acolab/line_follower_robot/README.md

# line_follower_robot
FR :
Ce repository permet de construire et programmer un robot à deux roues capable de suivre une ligne noire.
Il comprend:
- BOM.md : la liste du matériel
- base/line_follower_base.dxf : fichier décrivant la base du robot
- base/line_follower_base.scad : fichier openScad permettant de modifier la base du robot

EN :
