acolab/line_follower_robot/Robots suiveurs de lignes.pdf

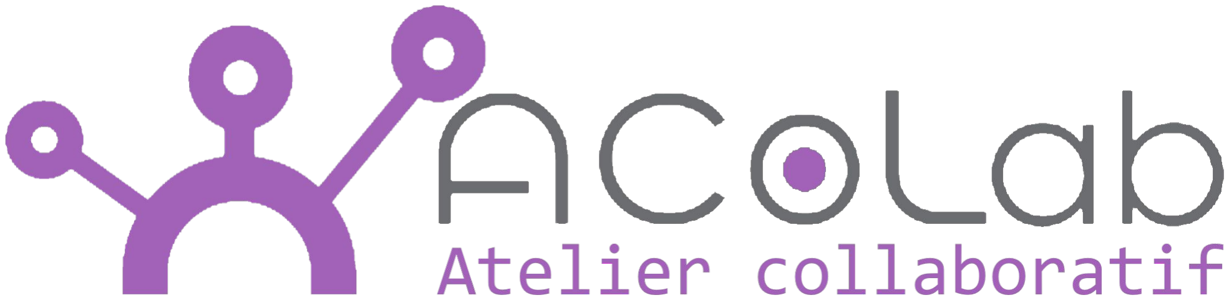
[picture p1: figure]

# atelier robots suiveurs de lignes

## Programme

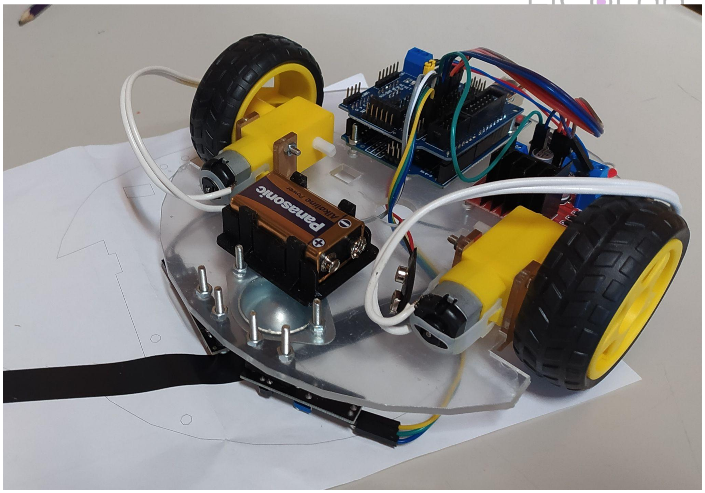
[picture p2: figure]

- Visite de l‘ACoLab
- Montage mécanique
- Détection des lignes
- Suivi des lignes

## ACoLab : atelier collaboratif

- Un lieu pour réaliser vos projets
- Un atelier avec des machines à dispositions des adhérents
- Des formations à l’usage des machines et des technologies
- Fonctionnement uniquement bénévole

## CONNEXIONS, cultivons le numérique

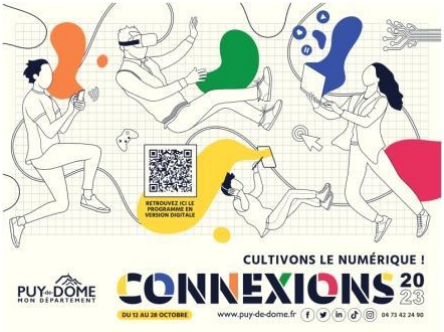
[picture p3: figure]

## Description du robot

Robot ‘differential drive’ : deux roues centrales indépendantes + 1 roulette

- base plexiglas, vis, écrous, roue libre
- 2 moteur + supports + roue
- 2 capteurs infrarouge + support
- carte L298N pour l’alimentation de l’arduino et le pilotage des moteurs
- carte arduino pour la programmation
- carte sensor shield v5
- pile 9V + support + connecteur
- interrupteur, câbles dupont

## Soudure

Couper et dénuder 5 à 10 cm de câble
Souder le câble rouge du connecteur de pile sur le I de l’interrupteur
Souder le petit câble sur le O de l’interrupteur
Mettre une cosse sur le petit câble et une sur le câble noir du connecteur de pile

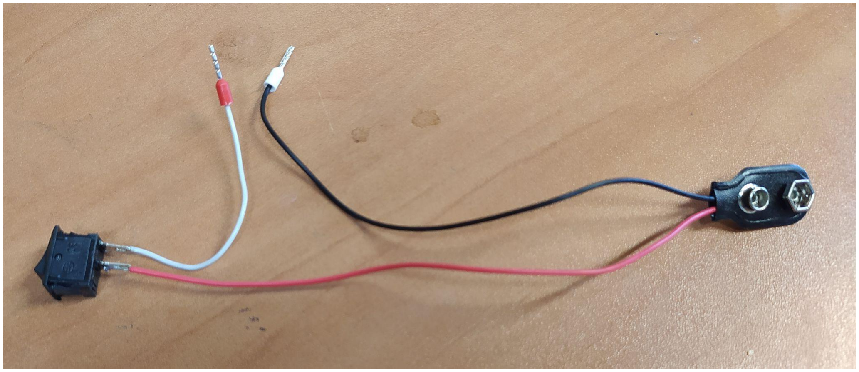
[picture p4: figure]

## Montage mécanique

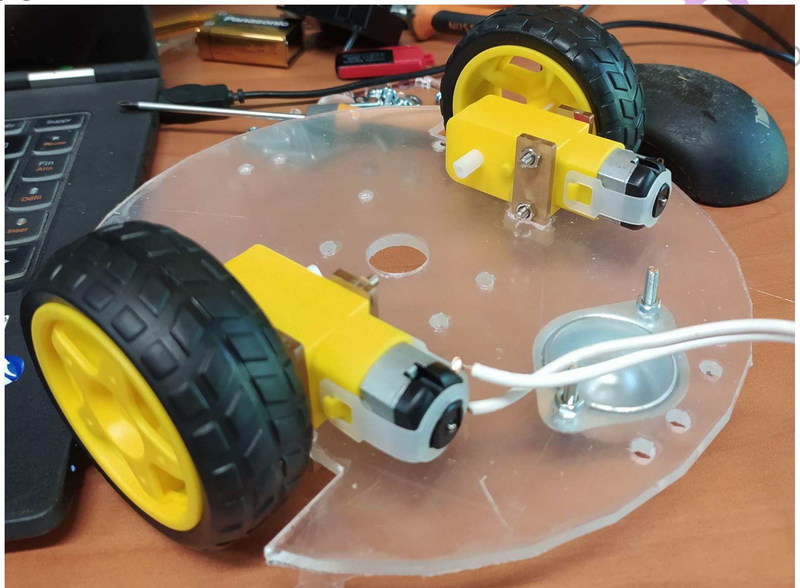
[picture p5: figure]

moteurs et roues

roue libre

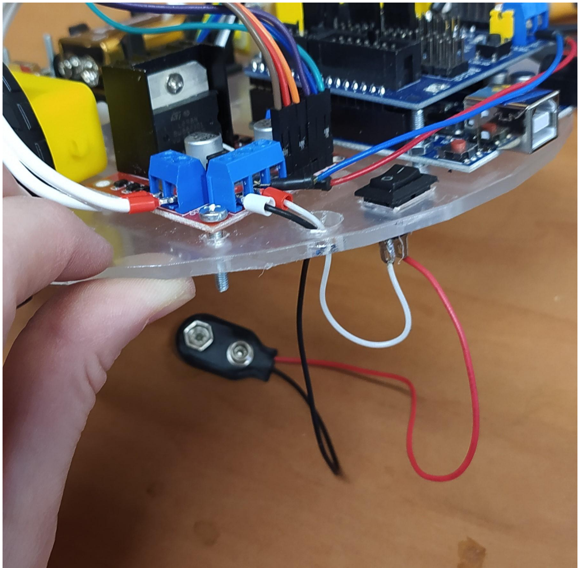
[picture p6: figure]

## Montage mécanique

support de pile + interrupteur

## Montage mécanique

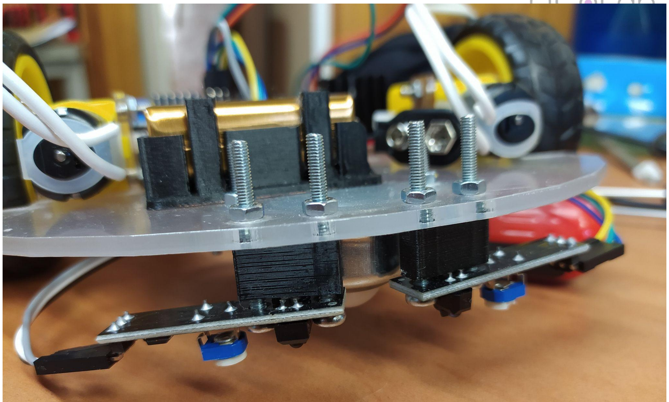
[picture p7: figure]

capteurs infrarouge

## Carte arduino

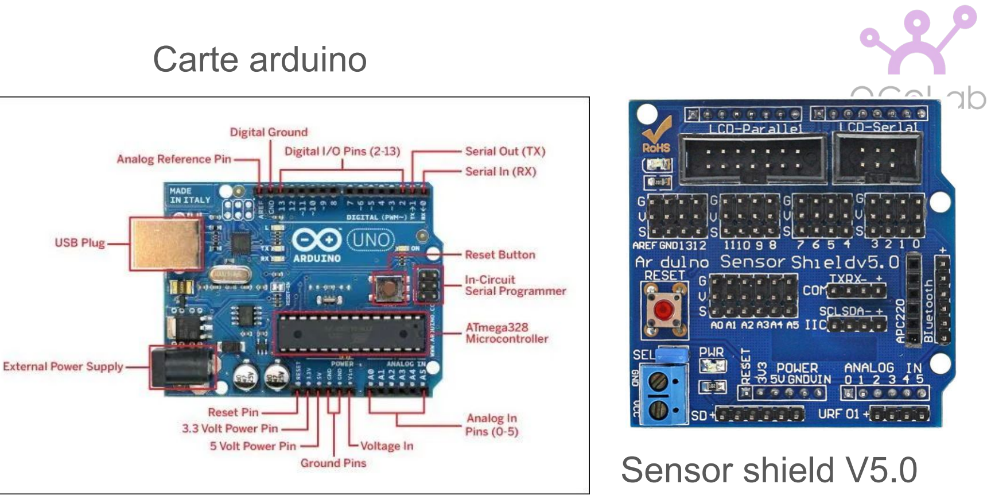
[picture p8: page 10]

## Sensor shield V5.0

## Montage mécanique

carte arduino, carte sensor shield V5

câblage capteur infrarouge sur le 2 et le 3

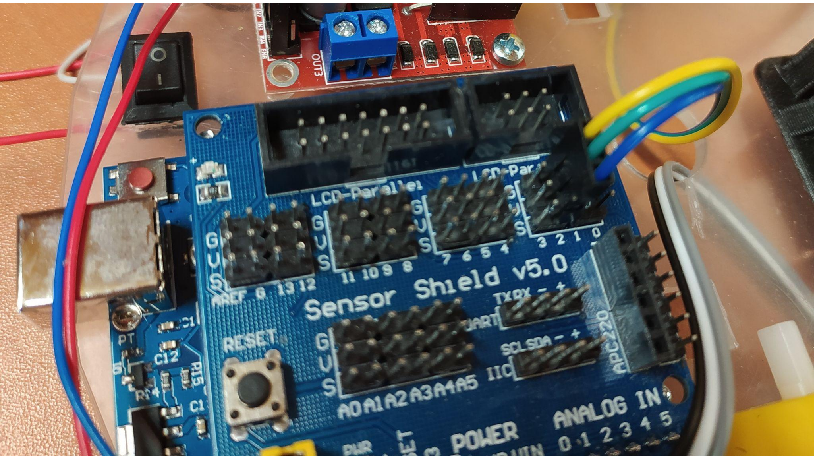
[picture p9: figure]

## Carte arduino

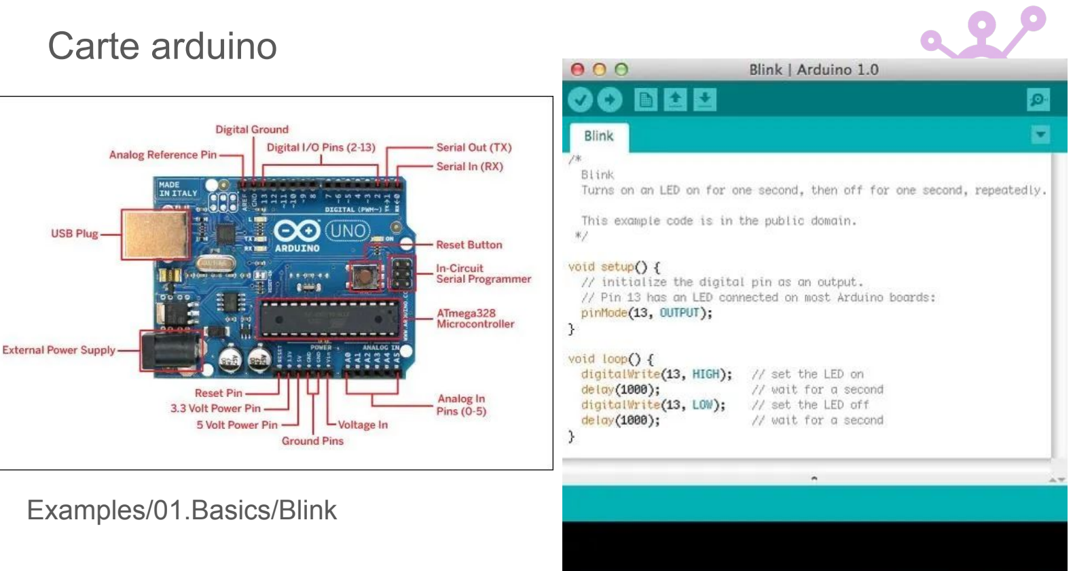
[picture p10: page 12]

Examples/01.Basics/Blink

## Capteurs infrarouge

- alimenter l’arduino avec le cable USB
- Voir que le capteur infrarouge s’allume/s’éteint en fonction de la présence du noir/blanc
- régler les potentiomètres sur le capteurs pour la détection de la ligne

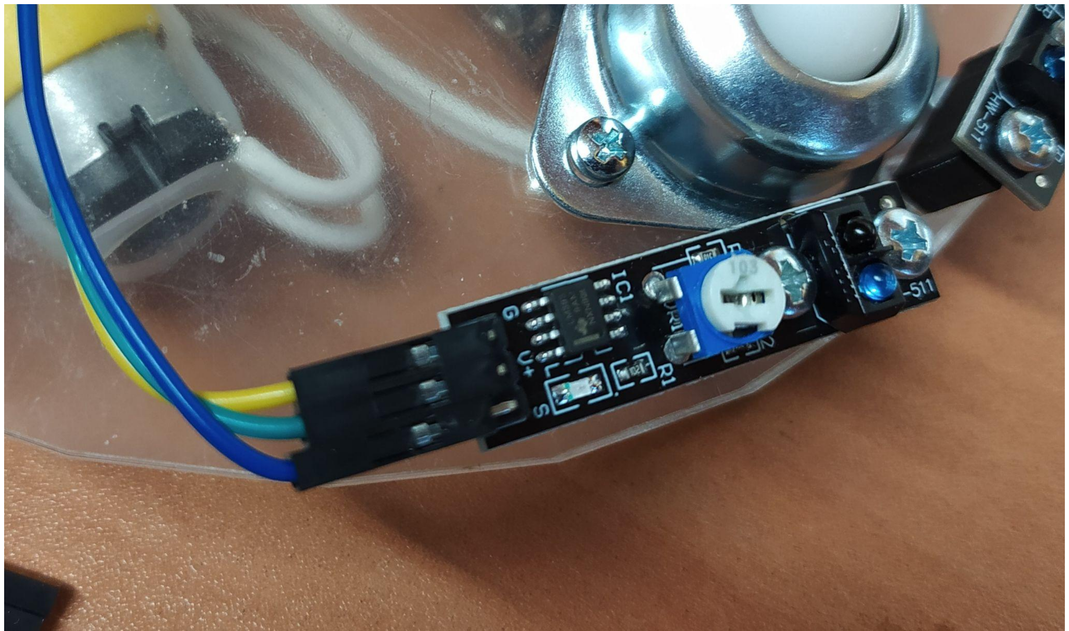
[picture p11: figure]

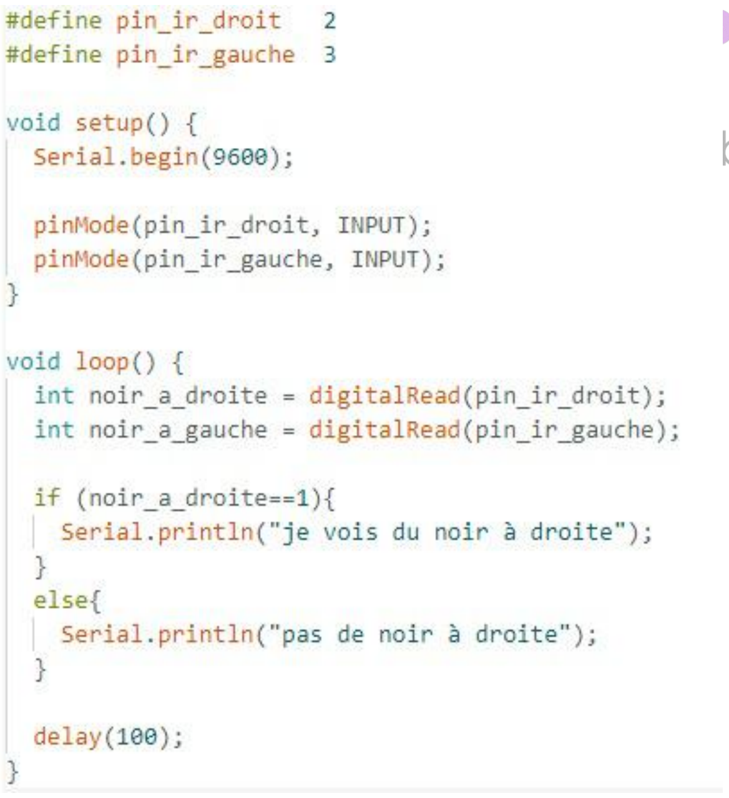
[picture p12: figure]

## Capteurs infrarouge

- code arduino
- Examples/01.Basics/

DigitalReadSerial

## Carte L298N

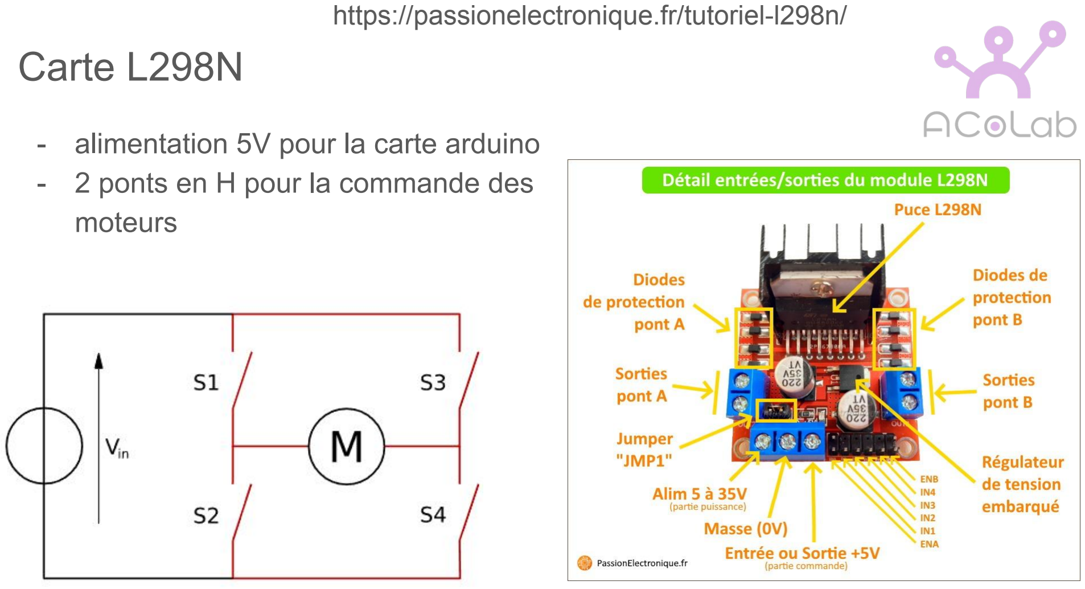
[picture p13: page 15]

- alimentation 5V pour la carte arduino
- 2 ponts en H pour la commande des moteurs

https://passionelectronique.fr/tutoriel-l298n/

## Carte L298N

- moteur gauche vers out2
- moteur droit vers out3
- interrupteur vers +12V

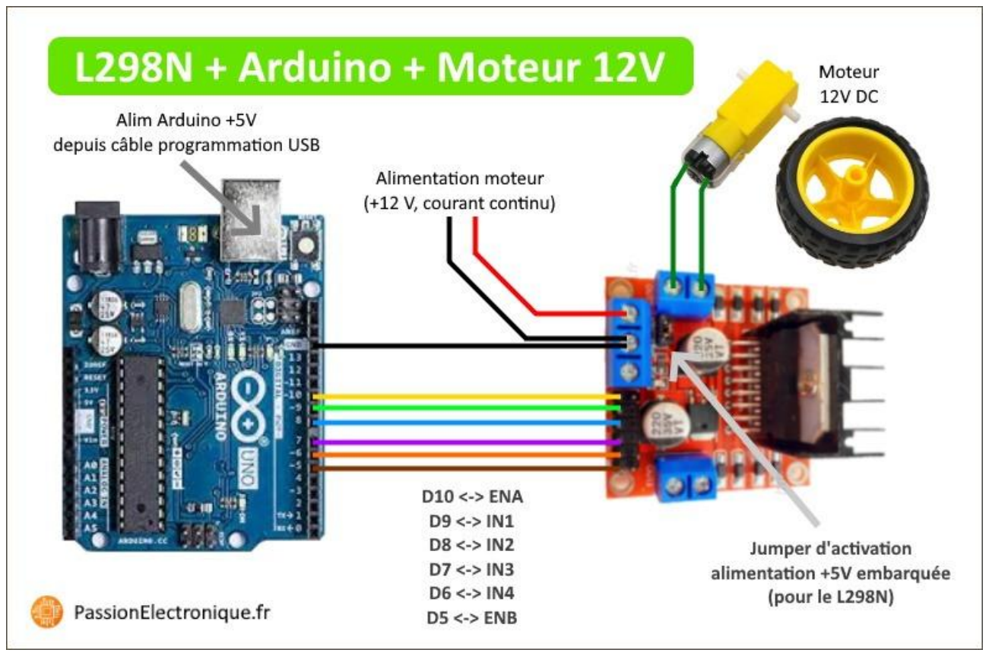
[picture p14: figure]

- câble noir pile + arduino vers GND et GND sur la carte capteurs
- Câble rouge de +5V vers VCC sur la carte capteurs
- 6 câbles ENA à ENB vers entrées 5 à 10 (pin V) sur la carte capteurs

## Carte L298N

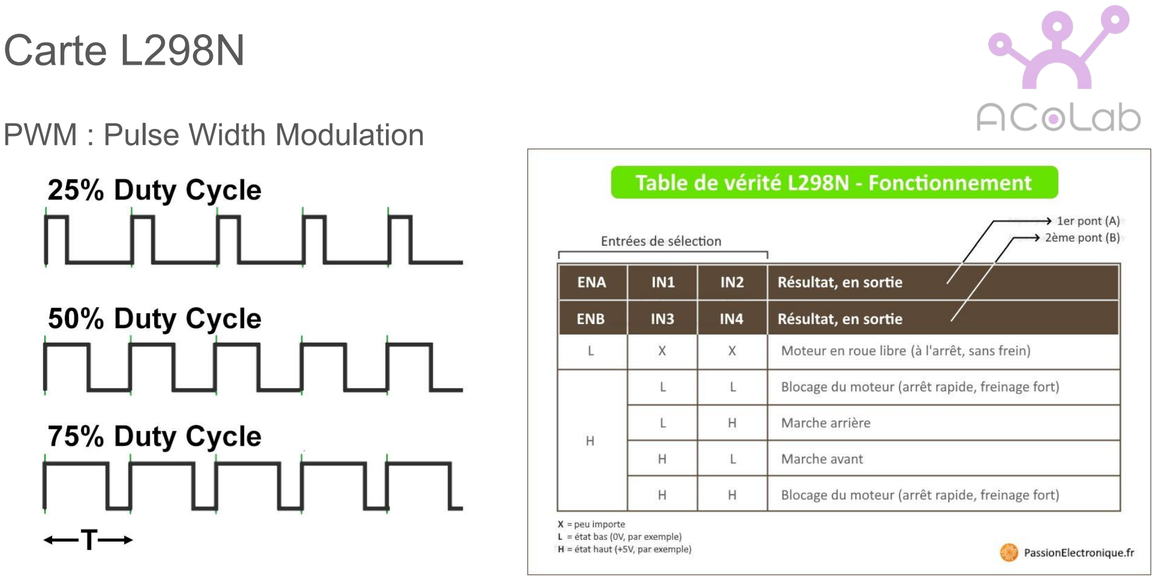
[picture p15: page 17]

PWM : Pulse Width Modulation

## Code

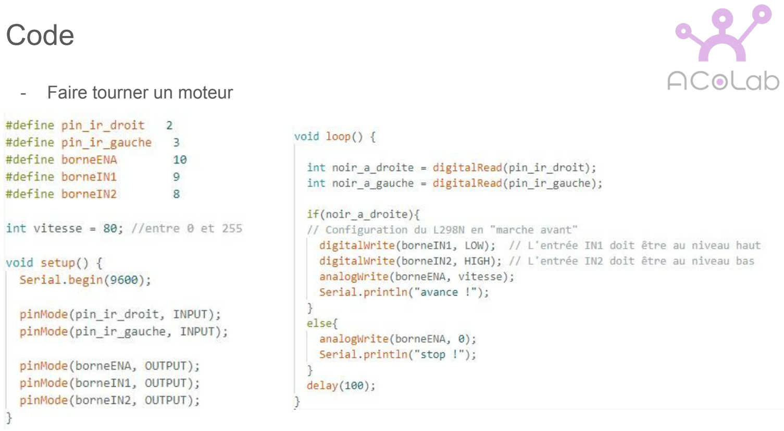
[picture p16: page 18]

- Faire tourner un moteur

## Programme de suivi de ligne

## A vous de jouer

# Merci d’avoir suivi cet atelier

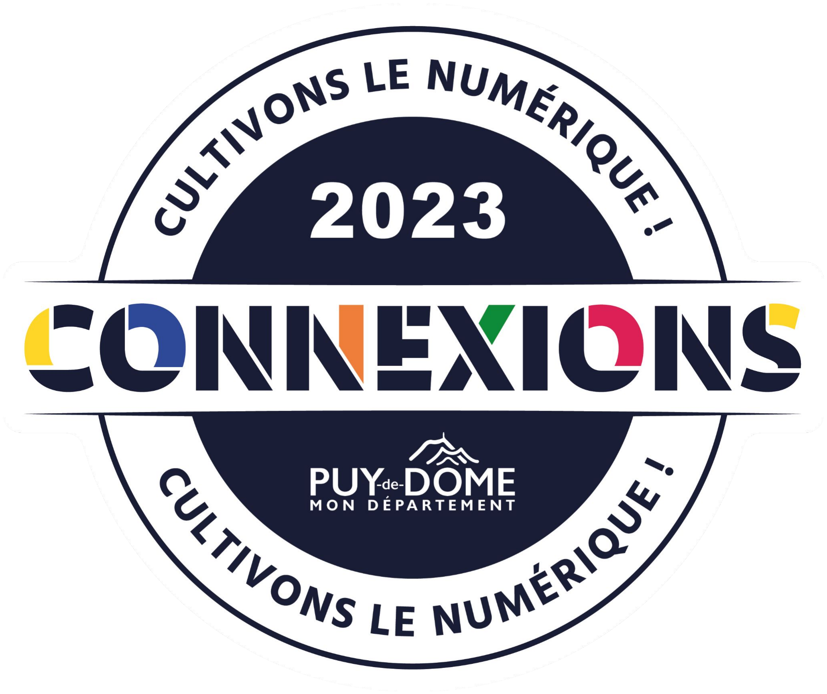
[picture p17: figure]
