acolab/line_follower_robot/BOM.md

Bill of Material

# To buy
boards:
- 1x Arduino Uno
- 1x Arduino sensor shield V5
- 1x H-bridge board L298N
- 2x infrared sensor TCRT5000 board size 42mmx10mm (https://www.aliexpress.com/item/1005002821466696.html?spm=a2g0o.order_list.order_list_main.65.28a81802BNh8zq)

hardware:
- 2x wheel and motor (130motor)
- 20mm height caster wheel
- switch 10*15mm
- plexiglas sheet (200x200x3mm)

cables:
- 9V battery connection cable
- 12x dupont wire F-F 
- 2x dupont wire M-M
- some wire + crimp terminal

# To make
- 1x base using the base/line_follower_robot_base.dxf, cut in a 3mm plexiglas sheet using a laser cutter
- 1x battrery holder using file from https://www.thingiverse.com/thing:2605589/files
- 2x IR spacer using the stl/IR_sensor_holder.stl and a 3D printer
