acolab/line_follower_robot/base/support_moteur.dxf

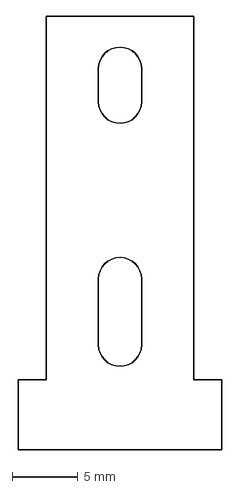
[picture p18: CAD file, 2025-01-18]
base/support_moteur.dxf
15.5 x 33.0 mm
