acolab/line_follower_robot/stl/pp3_holder_latest.stl

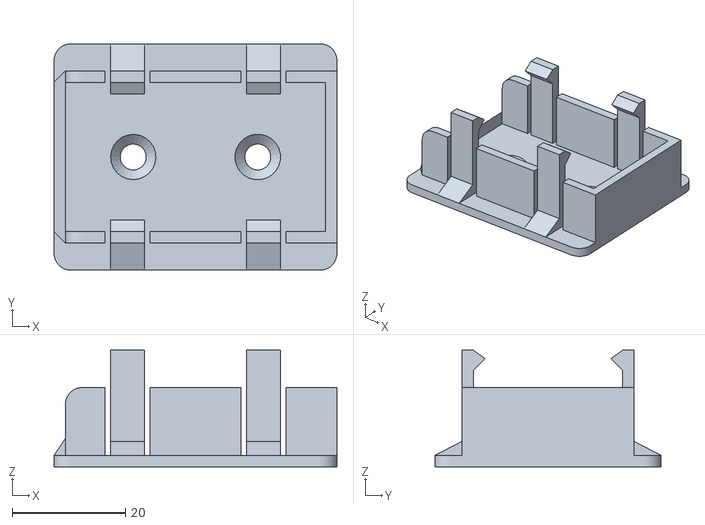
[picture p19: CAD file, 2023-12-03]
stl/pp3_holder_latest.stl
50.0 x 40.0 x 20.6
