acolab/line_follower_robot/base/line_follower_base.dxf

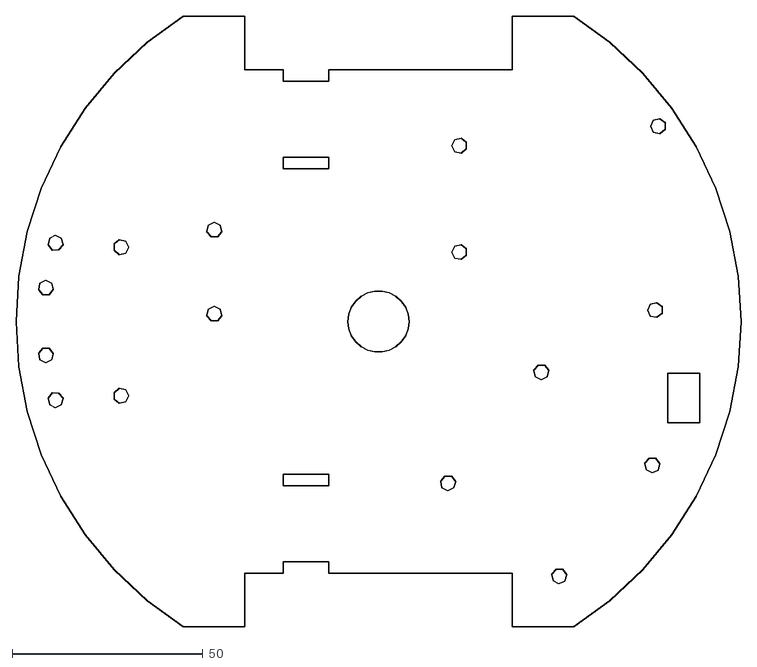
[picture p20: CAD file, 2025-01-18]
base/line_follower_base.dxf
190.0 x 160.0
