acolab/line_follower_robot/stl/ir_sensor_holder.stl

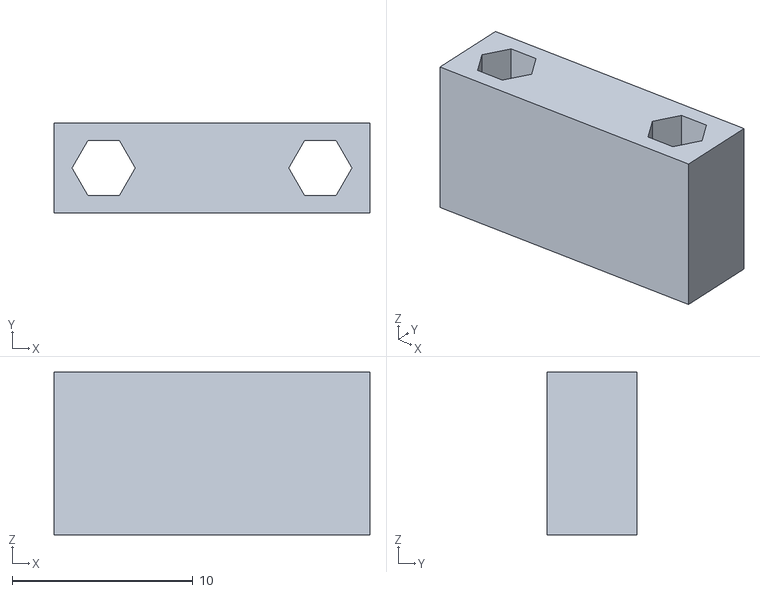
[picture p21: CAD file, 2023-12-03]
stl/ir_sensor_holder.stl
17.5 x 5.00 x 9.00
