acolab/line_follower_robot/(commit log)

2023-12-03 updated base, adding stls
    [ir_sensor_holder.stl, line_follower_base.dxf, line_follower_base.scad, pp3_holder_latest.stl]
2025-01-18 new version of base, code example and pdf (in french)
    [line_follower_base.dxf, line_follower_base.scad, support_moteur.scad]
2025-01-18 support moteur
    [support_moteur.dxf, support_moteur.scad]
